GeoJetta/NEMO/CAD/hero.png

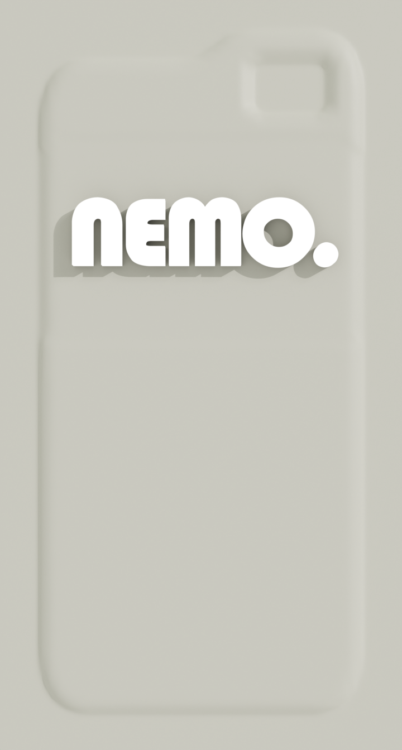
CAD/hero.png
