GeoJetta/NEMO/Docs/image-8.png

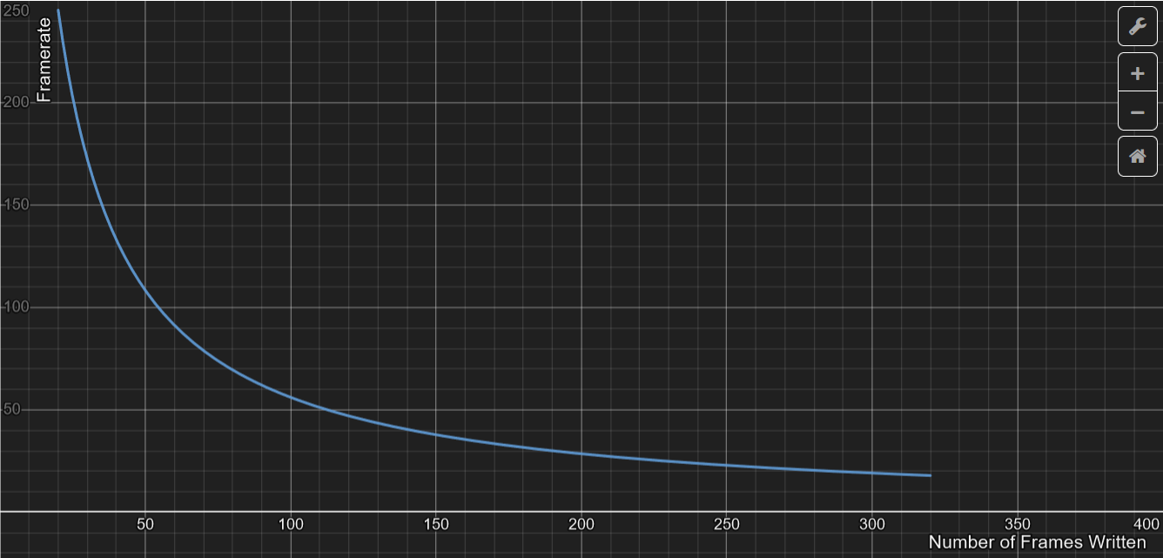
Docs/image-8.png
