GeoJetta/NEMO/Docs/Web/img/heroBot.png

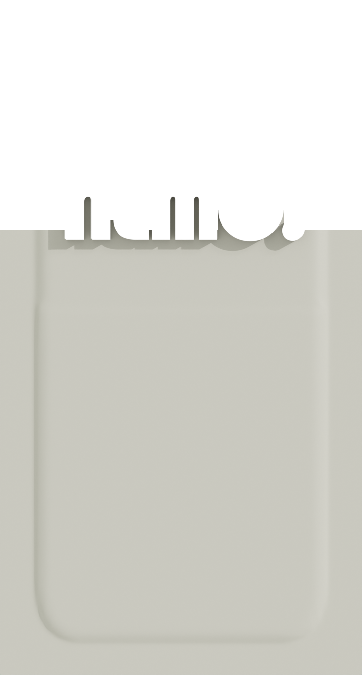
Docs/Web/img/heroBot.png
