GeoJetta/NEMO/Docs/Web/img/heroText.png

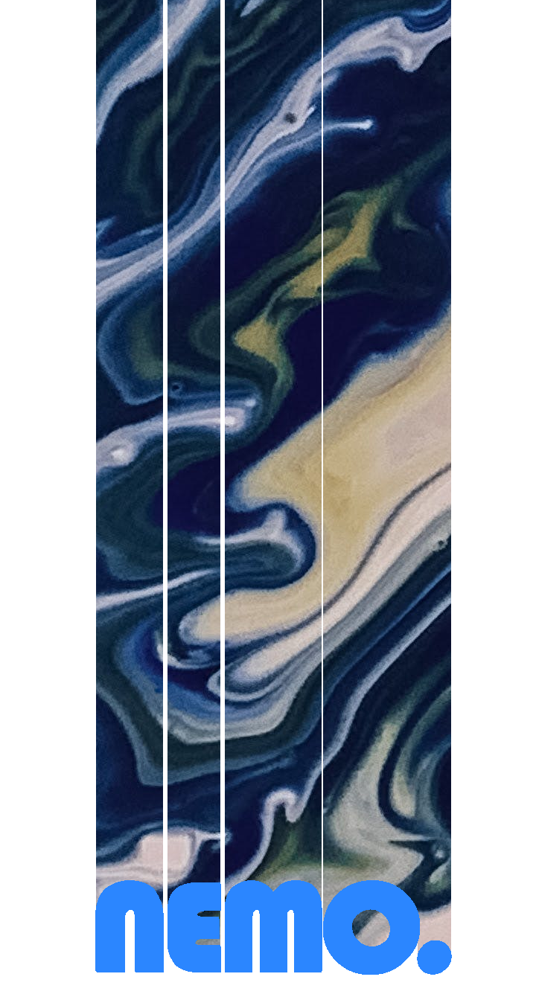
Docs/Web/img/heroText.png
