GeoJetta/NEMO/Docs/Web/img/heroTop.png

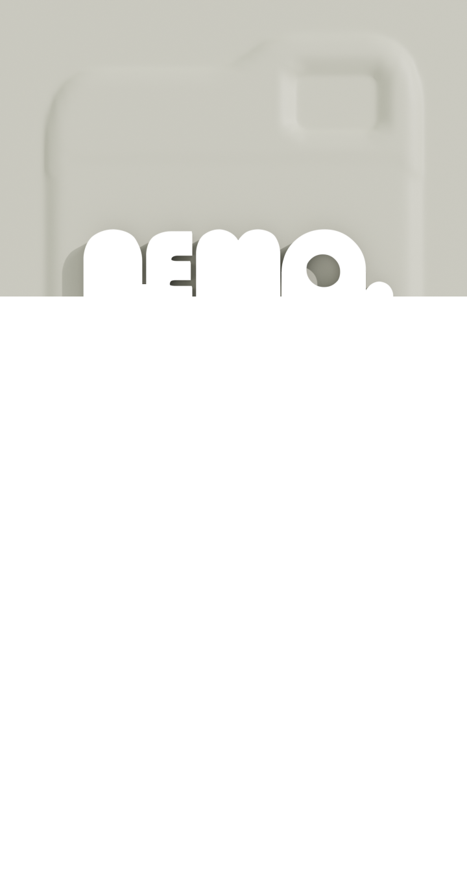
Docs/Web/img/heroTop.png
