GeoJetta/NEMO/CAD/nemo.obj

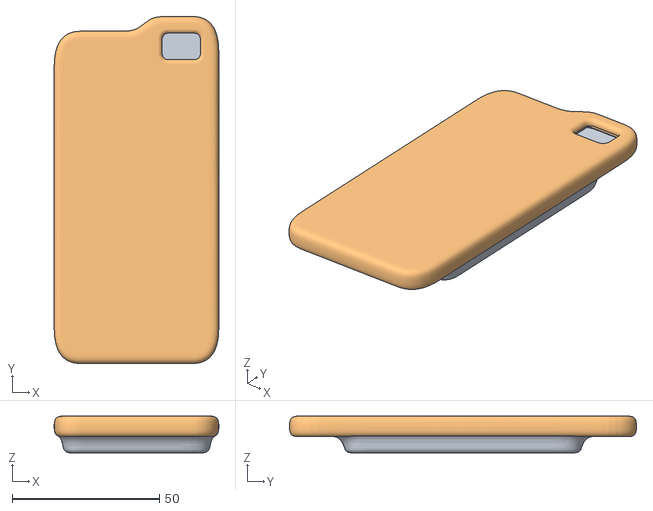
[picture p18: CAD file, 2023-11-28]
CAD/nemo.obj
56.0 x 118.0 x 12.5
Back
Lofted.003
