GeoJetta/NEMO/Hardware/mvpUI/nemo_modernist.dxf

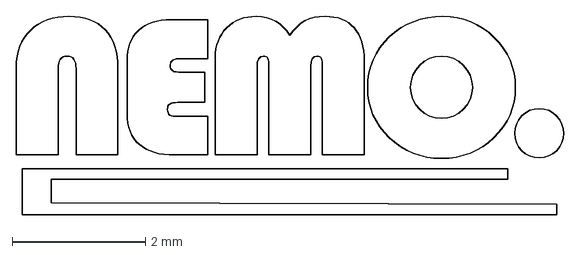
[picture p19: CAD file, 2023-11-12]
Hardware/mvpUI/nemo_modernist.dxf
8.23 x 2.98 mm
