GeoJetta/NEMO/(list of files, cad)

Other CAD files:
CAD/hero.blend
CAD/nemo.blend
