GeoJetta/NEMO/Hardware/displayBreakout/displayBreakout/displayBreakout.kicad_pcb

## KiCad design Hardware/displayBreakout/displayBreakout/displayBreakout.kicad_pcb (2023-11-20)

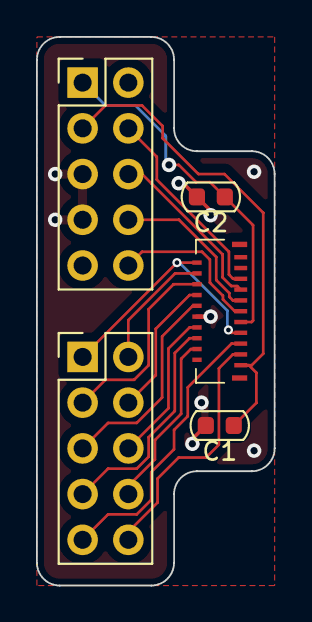
[picture p20: board displayBreakout.kicad_pcb from above]

Board: 2 copper layers, 13.2 x 30.5 mm, 5 parts (0 on the bottom side), 17 nets.

Parts:
C1, C2: 1uF; C_0603_1608Metric
J1: 503566-2102; 5035662102
J2, J3: Conn_02x05_Odd_Even; PinHeader_2x05_P2.54mm_Vertical

Connections:
+3.3V: C2.1, J1.9 (VDD1), J2.1
+5V: C1.1, J1.1 (VDD2), J2.3
/B0: J1.17 (B0), J2.4
/B1: J1.18 (B1), J3.2
/BCK: J1.12 (BCK), J3.5
/BSP: J1.11 (BSP), J2.10
/G0: J1.15 (G0), J2.6
/G1: J1.16 (G1), J3.3
/GCK: J1.4 (GCK), J3.8
/GEN: J1.5 (GEN), J3.9
/GSP: J1.3 (GSP), J3.10
/INTB: J1.6 (INTB), J3.7
/R0: J1.13 (R0), J2.8
/R1: J1.14 (R1), J3.4
/VA: J1.8 (VA), J3.6
/VCOM: J1.7 (VB), J1.20 (VCOM), J3.1
GND: C1.2, C2.2, J1.10 (VSS), J2.5, J2.7
