GeoJetta/NEMO/Hardware/mvpUI/mvpUI.kicad_pcb

## KiCad design Hardware/mvpUI/mvpUI.kicad_pcb (2023-11-12)

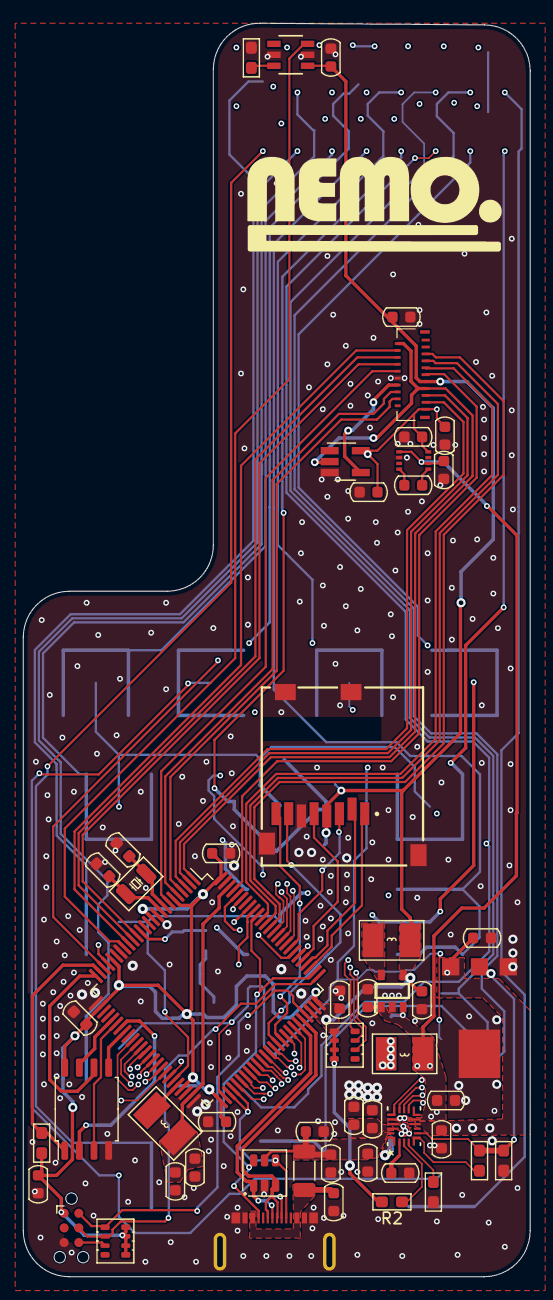
[picture p21: board mvpUI.kicad_pcb from above]

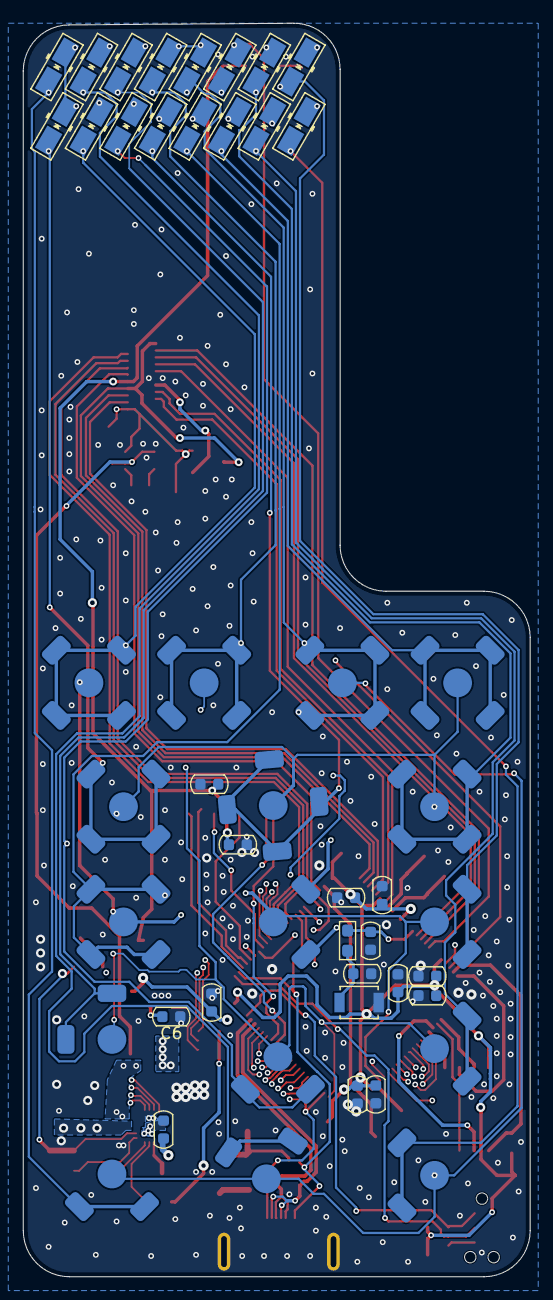
[picture p22: board mvpUI.kicad_pcb from below]

Board: 4 copper layers, 44.0 x 108.8 mm, 102 parts (48 on the bottom side), 87 nets.

Parts:
C1, C16, C20, C21, C36, C44, C51: 10uF; C_0603_1608Metric
C2, C32, C37, C38, C45, C46, C47, C49, C52, C53: 100nF; C_0603_1608Metric
C3, C4, C5, C39, C48, C50: 1uF; C_0603_1608Metric
C6, C15, C18, C35, C40: 0.1uF; C_0603_1608Metric
C13: 10pF; C_0603_1608Metric
C14: 22nF; C_0603_1608Metric
C17, C33, C43: 4.7uF; C_0603_1608Metric
C19: 22uF; C_0603_1608Metric
C29, C30: 3.9pF; C_0603_1608Metric
C31: 10nF; C_0603_1608Metric
C34: 100nF X7R; C_0603_1608Metric
C41: 47nF; C_0603_1608Metric
C42: 20uF; C_0603_1608Metric
C54, C55: 2.2uF; C_0603_1608Metric
D1, D2, D4, D5, D6, D7, D8, D9, D10, D11, D12, D13, D14, D15, D16, D17: D; D_MicroMELF_Handsoldering
D3: USBLC6-4SC6; SOT-23-6
F1: Polyfuse; L_1206_3216Metric_Pad1.22x1.90mm_HandSolder
IC1: XC9265B331MR-G; SOT95P280X130-5N
J1: Conn_ARM_SWD_TagConnect_TC2030-NL; Tag-Connect_TC2030-IDC-NL_2x03_P1.27mm_Vertical
J2: 54-00305; CX90BW-16P
J3: MEM2061-01-188-00-A_REVA; GCT_MEM2061-01-188-00-A_REVA
J4: 503566-2102; 5035662102
L2: 10uH; L_Taiyo-Yuden_NR-30xx_HandSoldering
L3: 2.2uH; L_Taiyo-Yuden_NR-30xx_HandSoldering
L4: 1uH; L_Taiyo-Yuden_NR-30xx_HandSoldering
R1, R2: 10k; R_0603_1608Metric_Pad1.05x0.95mm_HandSolder
R3: 1K; R_0603_1608Metric_Pad1.05x0.95mm_HandSolder
R4: 5.3k; R_0603_1608Metric_Pad1.05x0.95mm_HandSolder
R5: 31.1k; R_0603_1608Metric_Pad1.05x0.95mm_HandSolder
R6: 5k; R_0603_1608Metric_Pad1.05x0.95mm_HandSolder
R9: 910; R_0603_1608Metric_Pad1.05x0.95mm_HandSolder
RN1: 4x10k; R_Array_Convex_4x0603
RN2: 4x47; R_Array_Convex_4x0603
SW1: SW_Push; SW_SPST_B3U-1000P
SW3, SW4, SW5, SW6, SW15, SW16, SW17, SW18: snap_dome; snap dome_1
SW7, SW8, SW9, SW10, SW11, SW12, SW13, SW14: snap_dome; snap dome_2
U1: MX25R3235FM2xx0; SOP-8_5.28x5.23mm_P1.27mm
U2: 00-9155-003-00 3 Pin Spring Connector
U3: PTMAG5328A1DQDBVR; SOT23_DBV_TEX-M
U4: 74LVC1GU04DRL; SOT-23-5_HandSoldering
U5: BQ25622ERYKR; WQFN-HR18_RYK_TEX
U6: S-882150APH
U8: STM32U585VIT6Q; LQFP-100_14x14mm_P0.5mm
Y2: Crystal; Crystal_SMD_3215-2Pin_3.2x1.5mm

Connections:
+3.3V: C1.1, C2.1, C3.1, C5.1, C19.1, C34.2, C36.1, C37.1, C38.1, C45.1, C46.1, C47.1, C48.1, C49.1, C50.1, C51.1, C52.1, C53.1, IC1.4 (VOUT), J1.1 (VCC), J3.4 (VDD), J4.9 (VDD1), L2.2, R1.2, R2.2, RN1.5 (R4.2), RN1.6 (R3.2), RN1.7 (R2.2), RN1.8 (R1.2), RN2.5 (R4.2), RN2.6 (R3.2), RN2.7 (R2.2), RN2.8 (R1.2), U1.8 (VCC), U3.4 (VCC), U8.6 (VBAT), U8.11 (VDD), U8.21 (VDDA), U8.27 (VDD), U8.47 (VDDSMPS), U8.51 (VDD), U8.73 (VDDUSB), U8.75 (VDD), U8.100 (VDD)
+5V: C4.1, C21.1, C35.1, J4.1 (VDD2), U4.5 (VCC), U6.4 (VOUT)
/Connectors/B0: J4.17 (B0), U8.88 (PD7)
/Connectors/B1: J4.18 (B1), U8.17 (PC2)
/Connectors/BCK: J4.12 (BCK), U8.7 (PC13)
/Connectors/BSP: J4.11 (BSP), U8.97 (PE0)
/Connectors/CC1: D3.6 (L4), J2.A5 (CC1), U8.77 (PA15), U8.91 (PB5)
/Connectors/CC2: D3.4 (L3), J2.B5 (CC2), U8.53 (PB14), U8.54 (PB15)
/Connectors/D+: D3.3 (L2), J2.A6 (DP1), J2.B6 (DP2), U8.71 (PA12)
/Connectors/D-: D3.1 (L1), J2.A7 (DN1), J2.B7 (DN2), U8.70 (PA11)
/Connectors/G0: J4.15 (G0), U8.89 (PB3)
/Connectors/G1: J4.16 (G1), U8.16 (PC1)
/Connectors/GCK: J4.4 (GCK), U8.4 (PE5)
/Connectors/GEN: J4.5 (GEN), U8.2 (PE3)
/Connectors/GSP: J4.3 (GSP), U8.3 (PE4)
/Connectors/INTB: J4.6 (INTB), U8.5 (PE6)
/Connectors/R0: J4.13 (R0), U8.90 (PB4)
/Connectors/R1: J4.14 (R1), U8.15 (PC0)
/Connectors/TEMP: R4.2, R5.2, U2.2 (TEMP), U5.6 (TS)
/Connectors/V+: C15.1, C44.1, U2.3 (+), U5.8 (BAT)
/Connectors/VA: J4.8 (VA), U4.4
/Connectors/VBUS: C32.2, C33.2, C39.1, D3.5 (VP), F1.1, U5.18 (VBUS)
/Connectors/VBUS_RAW: C31.1, F1.2, J2.A4_B9 (VBUS_1), J2.B4_A9 (VBUS_2)
/Connectors/VCOM: J4.7 (VB), J4.20 (VCOM), U4.2, U8.1 (PE2)
/MCU/INT: RN1.4 (R4.1), U5.11 (*INT), U8.96 (PB9)
/MCU/KEYPAD.C0: D6.1 (K), D7.1 (K), D8.1 (K), D9.1 (K), U8.81 (PD0)
/MCU/KEYPAD.C1: D10.1 (K), D11.1 (K), D12.1 (K), D13.1 (K), U8.82 (PD1)
/MCU/KEYPAD.C2: D14.1 (K), D15.1 (K), D16.1 (K), D17.1 (K), U8.23 (PA1)
/MCU/KEYPAD.C3: D1.1 (K), D2.1 (K), D4.1 (K), D5.1 (K), U8.22 (PA0)
/MCU/KEYPAD.R0: SW12.1 (+), SW13.1 (+), SW14.1 (+), SW15.1 (+), U8.43 (PE15)
/MCU/KEYPAD.R1: SW9.1 (+), SW10.1 (+), SW11.1 (+), SW16.1 (+), U8.52 (PB13)
/MCU/KEYPAD.R2: SW6.1 (+), SW7.1 (+), SW8.1 (+), SW17.1 (+), U8.45 (PB11)
/MCU/KEYPAD.R3: SW3.1 (+), SW4.1 (+), SW5.1 (+), SW18.1 (+), U8.44 (PB10)
/MCU/LSE_IN: C29.1, U8.8 (PC14), Y2.1
/MCU/LSE_OUT: C30.1, U8.9 (PC15), Y2.2
/MCU/MAG1_OUT: U3.6 (OUT), U8.18 (PC3)
/MCU/QSPI_102: U1.3 (~WP/SIO2), U8.31 (PA7)
/MCU/QSPI_CLK: U1.6 (SCLK), U8.25 (PA3)
/MCU/QSPI_IO0: U1.5 (SI/SIO0), U8.33 (PB1)
/MCU/QSPI_IO1: U1.2 (SO/SIO1), U8.32 (PB0)
/MCU/QSPI_IO3: U1.7 (~RESET/SIO3), U8.30 (PA6)
/MCU/QSPI_NCS: R1.1, U1.1 (~CS), U8.24 (PA2)
/MCU/SCL: RN1.2 (R2.1), U5.13 (SCL), U8.92 (PB6)
/MCU/SDA: RN1.3 (R3.1), U5.12 (SDA), U8.93 (PB7)
/MCU/SD_CLK: J3.5 (CLK), U8.80 (PC12)
/MCU/SD_CMD: J3.3 (CMD), U8.83 (PD2)
/MCU/SD_IO0: J3.7 (DAT0), U8.65 (PC8)
/MCU/SD_IO1: J3.8 (DAT1), U8.66 (PC9)
/MCU/SD_IO2: J3.1 (DAT2), U8.78 (PC10)
/MCU/SD_IO3: J3.2 (CD/DAT3), U8.79 (PC11)
/MCU/SWCLK: J1.4 (SWCLK), RN2.2 (R2.1), U8.76 (PA14)
/MCU/SWDIO: J1.2 (SWDIO), RN2.1 (R1.1), U8.72 (PA13)
/MCU/SWO: J1.6 (SWO), RN2.3 (R3.1)
/MCU/VDD11C: C54.1, C55.1, L3.1, U8.49 (VDD11), U8.98 (VDD11)
/MCU/VLXS: L3.2, U8.46 (VLXSMPS)
/MCU/~CE: U5.14 (CE), U8.95 (PB8)
GND: C1.2, C2.2, C3.2, C4.2, C5.2, C6.1, C13.1, C14.1, C15.2, C16.2, C17.2, C19.2, C20.2, C21.2, C29.2, C30.2, C31.2, C32.1, C33.1, C34.1, C35.2, C36.2, C37.2, C38.2, C39.2, C40.2, C42.2, C43.2, C44.2, C45.2, C46.2, C47.2, C48.2, C49.2, C50.2, C51.2, C52.2, C53.2, C54.2, C55.2, D3.2 (VN), IC1.2 (GND), J1.5 (GND), J2.A1_B12 (GND_1), J2.B1_A12 (GND_2), J2.S1 (SHIELD), J2.S2 (SHIELD__1), J2.S3 (SHIELD__2), J2.S4 (SHIELD__3), J3.6 (VSS), J3.9 (CD1), J3.10 (CD2), J3.11 (GND), J3.12 (GND__1), J4.10 (VSS), R5.1, R6.2, R9.1, SW1.1, U1.4 (GND), U2.1 (GND), U2.4 (SHIELD), U3.2 (GND), U3.5 (TEST2), U4.3 (GND), U5.15 (GND), U6.6 (GND), U8.10 (VSS), U8.19 (VSSA), U8.26 (VSS), U8.48 (VSSSMPS), U8.50 (VSS), U8.74 (VSS), U8.99 (VSS)
unnamed: C13.2, R3.1, SW1.2
unnamed: D1.2 (A), SW18.2 (-)
unnamed: D2.2 (A), SW17.2 (-)
unnamed: D4.2 (A), SW16.2 (-)
unnamed: D5.2 (A), SW15.2 (-)
unnamed: D6.2 (A), SW3.2 (-)
unnamed: D7.2 (A), SW6.2 (-)
unnamed: D8.2 (A), SW9.2 (-)
unnamed: D9.2 (A), SW12.2 (-)
unnamed: D10.2 (A), SW4.2 (-)
unnamed: D11.2 (A), SW7.2 (-)
unnamed: D12.2 (A), SW10.2 (-)
unnamed: D13.2 (A), SW13.2 (-)
unnamed: D14.2 (A), SW5.2 (-)
unnamed: D15.2 (A), SW8.2 (-)
unnamed: D16.2 (A), SW11.2 (-)
unnamed: D17.2 (A), SW14.2 (-)
unnamed: C6.2, C16.1, C17.1, C42.1, IC1.1 (VIN), IC1.3 (CE), L4.1, U5.9 (SYS), U6.2 (VIN), U6.5 (ON/OFF)
unnamed: IC1.5 (LX), L2.1
unnamed: R6.1, U3.3 (ADJ)
unnamed: R2.1, U5.3 (*PG)
unnamed: C41.1, U5.1 (BTST)
unnamed: R9.2, U5.4 (ILIM)
unnamed: C20.1, C40.1, U5.17 (PMID)
unnamed: C43.1, U5.2 (REGN)
unnamed: C41.2, L4.2, U5.16 (SW)
unnamed: R4.1, U5.5 (TS_BIAS)
unnamed: C18.1, U6.1 (C+)
unnamed: C18.2, U6.8 (C-)
unnamed: C14.2, R3.2, U8.14 (NRST)
