GeoJetta/NEMO/(commit log)

2023-10-16 Initial File Migration
    [LTE.kicad_sch, connectors.kicad_sch, interface.kicad_sch, mcu.kicad_sch, misc.kicad_sch, mvpUI.kicad_pcb, mvpUI.kicad_sch, mvpUI.sch]
2023-10-20 Getting there...
    Just need logic and power planes for the most part (and verify everything once more)
    [connectors.kicad_sch, mcu.kicad_sch, misc.kicad_sch, mvpUI.kicad_pcb, mvpUI.kicad_sch, power.kicad_sch]
2023-10-22 Getting there part ii
    Started power planes, most of keyboard wired together
    [mcu.kicad_sch, misc.kicad_sch, mvpUI.kicad_pcb, power.kicad_sch]
2023-10-22 T-2 or 3ish
    Just keypad, decaps, and a checkover left!
    [mcu.kicad_sch, misc.kicad_sch, mvpUI.kicad_pcb]
2023-10-25 Ready to Review
    [mcu.kicad_sch, mvpUI.kicad_pcb, power.kicad_sch]
2023-11-02 Fixed Obvious Dumb
    [connectors.kicad_sch, mcu.kicad_sch, mvpUI.kicad_pcb, power.kicad_sch]
2023-11-12 Production!
    Forgot to commit the final, lets hope this works. Also start on software using Slint. Prototype in Plasticity on a free trial to test.
    [connectors.kicad_sch, mcu.kicad_sch, mvpUI.kicad_pcb, nemo_modernist.dxf, power.kicad_sch]
2023-11-13 Display Driver work
    [nemo.blend, nemo.obj]
2023-11-20 Display breakout PCB
    [displayBreakout.kicad_pcb, displayBreakout.kicad_sch]
2023-11-20 Framerate estimation
2023-11-28 Lots of experimenting and random stuff
    [hero.blend, nemo.obj]
